SamuelTYF/I2C/3_作品实物照片/实物图_PCB背部.jpg

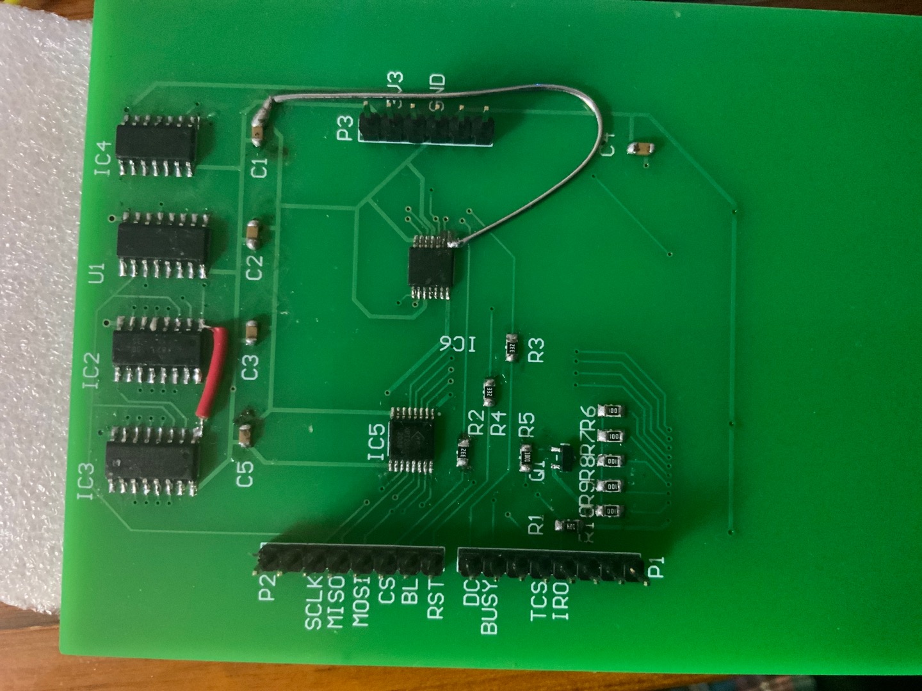
3_作品实物照片/实物图_PCB背部.jpg
