SamuelTYF/I2C/3_作品实物照片/实物图_连线.jpg

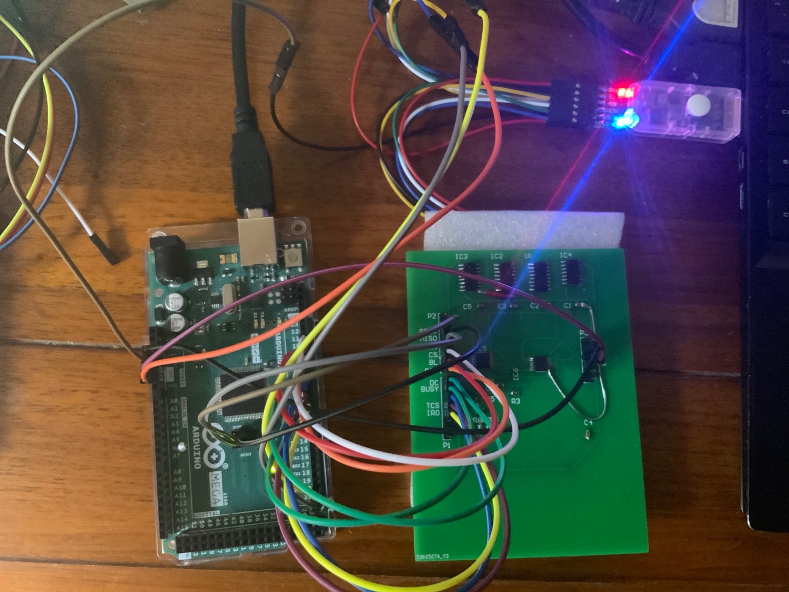
3_作品实物照片/实物图_连线.jpg
