SamuelTYF/I2C/其它文件/Net.drawio.png

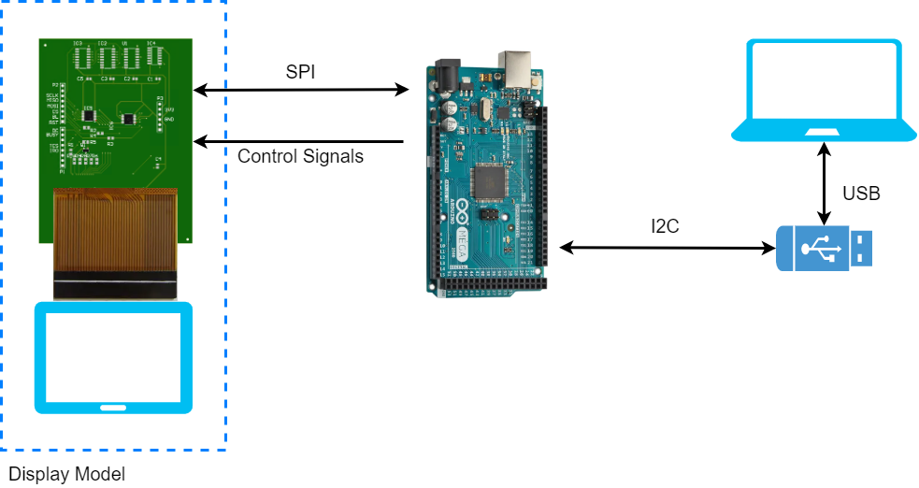
其它文件/Net.drawio.png
