SamuelTYF/I2C/其它文件/Touch.drawio.png

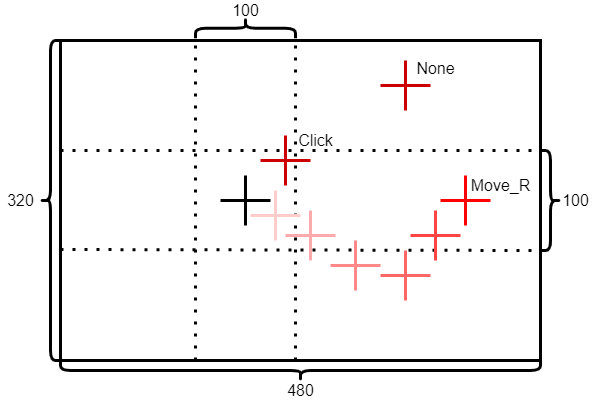
其它文件/Touch.drawio.png
