SamuelTYF/I2C/(list of files, drawings)

Other design files:
2_PCB工程/Touch/PCB2.PcbDoc
2_PCB工程/Touch/PcbLib1.PcbLib
2_PCB工程/Touch/Schlib1.SchLib
2_PCB工程/Touch/Sheet1.SchDoc
2_PCB工程/Touch/Touch.PrjPcb
