SamuelTYF/I2C/(commit log)

2022-10-06 软件系统集成完毕
    [PCB2.PcbDoc, PcbLib1.PcbLib, Schlib1.SchLib, Sheet1.SchDoc, Touch.PrjPcb]
2022-10-11 完成报告
    [PCB2.PcbDoc, Sheet1.SchDoc]
2022-10-14 整理文件
    [PCB2.PcbDoc, PcbLib1.PcbLib, Schlib1.SchLib, Sheet1.SchDoc, Touch.PrjPcb]
